CodeWracker/C.A.2017-18-ETECPV/Circuitos/Mesa-1/Lampadas/t73/Com ruido/Desenho/ts-ctrlampp18f4520-2017ver2.pdf

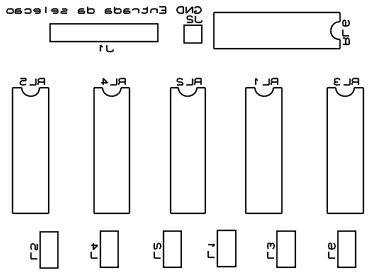
[picture p18: figure]
