CodeWracker/C.A.2017-18-ETECPV/Circuitos/Mesa-1/Lampadas/t73/Sem Ruído/Desenho/ts-ctrlampp18f4520-2017sr-v2.pdf

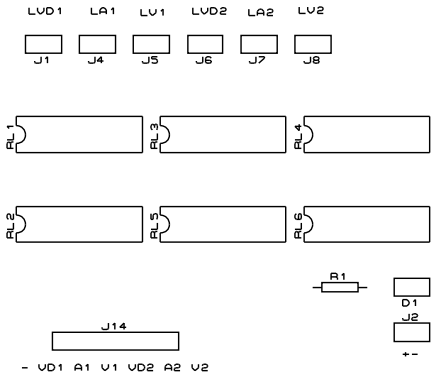
[picture p19: figure]
