CodeWracker/C.A.2017-18-ETECPV/Circuitos/Mesa-1/contadores/Contador de 0 até 60/4518/Sem Ruído/Desenho/ts-ct0a60cmsp18f4520-v1.pdf

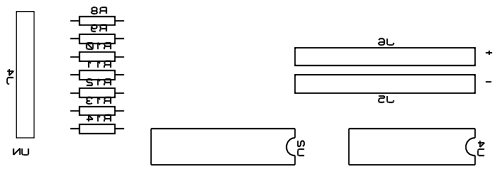
[picture p20: figure]
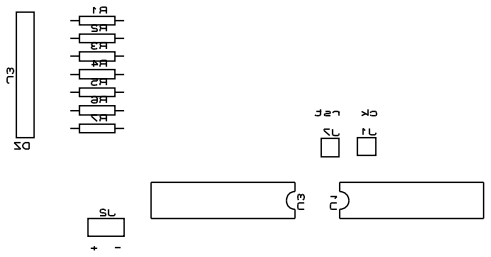
[picture p21: figure]
