CodeWracker/C.A.2017-18-ETECPV/Circuitos/Mesa-1/contadores/Contador de Pontos/4518/com ruido/Desenho/ts-ctptjxp18f4520v2.pdf

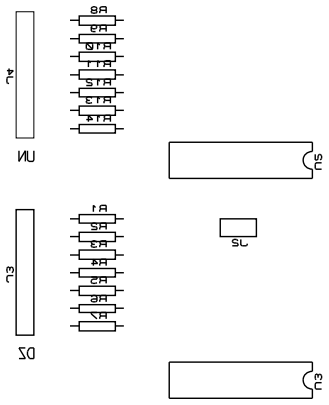
[picture p24: figure]
