CodeWracker/C.A.2017-18-ETECPV/Circuitos/Mesa-1/Lampadas/t73/Com ruido/Desenho/Jumps.png

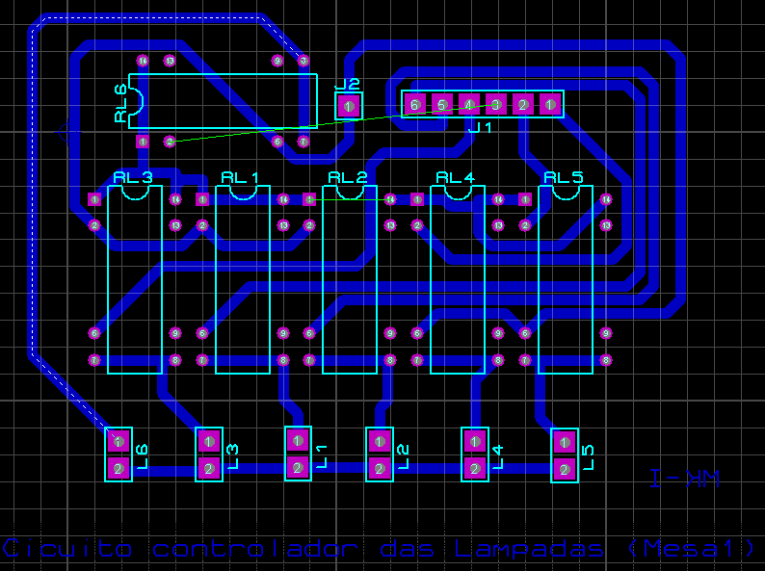
Circuitos/Mesa-1/Lampadas/t73/Com ruido/Desenho/Jumps.png
