CodeWracker/C.A.2017-18-ETECPV/Circuitos/Mesa-1/contadores/Contador de 0 até 60/4518/Sem Ruído/GerbCT0A60CMS - CADCAM Bottom Solder Resist.TXT

G04 PROTEUS RS274X GERBER FILE*
%FSLAX24Y24*%
%MOIN*%
%ADD18C,0.1000*%
%ADD19R,0.1000X0.1000*%
%ADD16C,0.0900*%
%ADD70C,0.1100*%
%ADD17C,0.0080*%
G54D18*
X+30250Y-17000D03*
X+41750Y-16500D03*
X+30875Y-20875D03*
X+35750Y-16500D03*
X+36750Y-16500D03*
X+31750Y-21750D03*
X+24500Y-17000D03*
X+39250Y-31250D03*
X+34750Y-25500D03*
X+37750Y-16500D03*
X+25500Y-21500D03*
X+31750Y-13000D03*
X+24500Y-18000D03*
X+24750Y-12000D03*
X+30250Y-18000D03*
X+29250Y-21000D03*
X+40250Y-31250D03*
G54D19*
X+44500Y-3750D03*
X+44500Y-4750D03*
X+44500Y-5750D03*
X+44500Y-6750D03*
X+44500Y-7750D03*
X+44500Y-8750D03*
X+44500Y-9750D03*
X+44500Y-10750D03*
G54D16*
X+39000Y-7750D03*
X+43000Y-7750D03*
X+39000Y-6750D03*
X+43000Y-6750D03*
X+39000Y-5750D03*
X+43000Y-5750D03*
X+39000Y-4750D03*
X+43000Y-4750D03*
X+39000Y-3750D03*
X+43000Y-3750D03*
X+39000Y-8750D03*
X+43000Y-8750D03*
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
