CodeWracker/C.A.2017-18-ETECPV/Circuitos/Mesa-1/Botoes/desenho/bc-btsv1.pdf

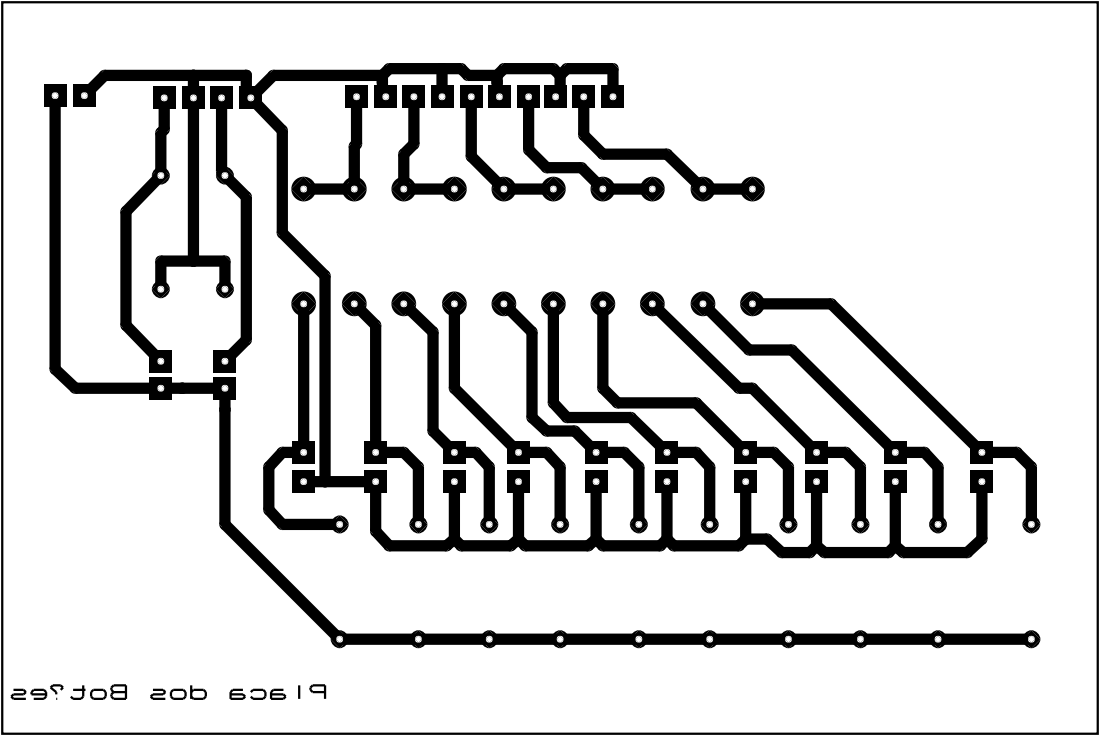
[picture p30: page 1]
