CodeWracker/C.A.2017-18-ETECPV/Circuitos/Mesa-1/Botoes/desenho/ts-btsv1.pdf

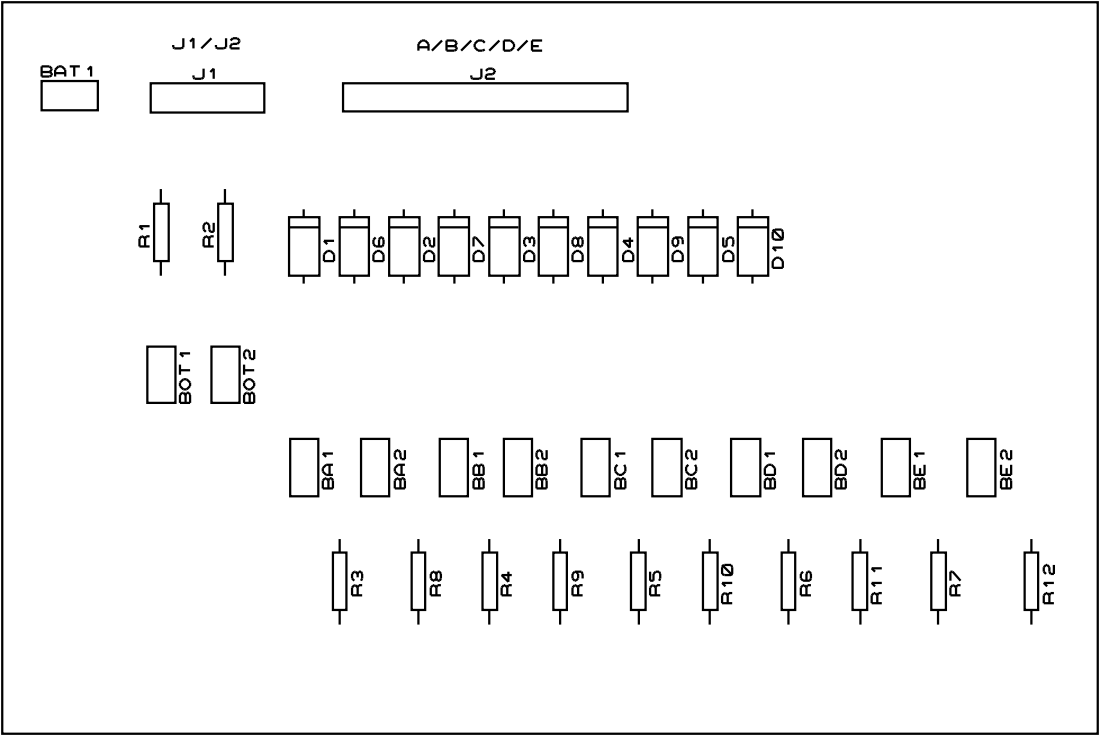
[picture p31: page 1]
