CodeWracker/C.A.2017-18-ETECPV/Circuitos/Mesa-1/Fonte/Desenho/bc-fontedc-6s5v1s9v1a.pdf

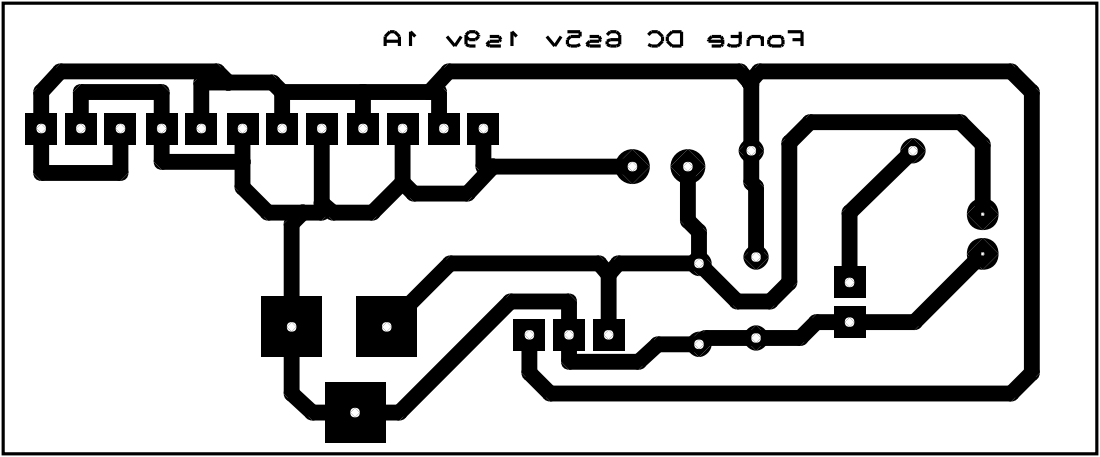
[picture p33: page 1]
