CodeWracker/C.A.2017-18-ETECPV/Circuitos/Mesa-1/Lampadas/t73/Com ruido/Desenho/BC-CtrLampP18F4520-2017ver1.pdf

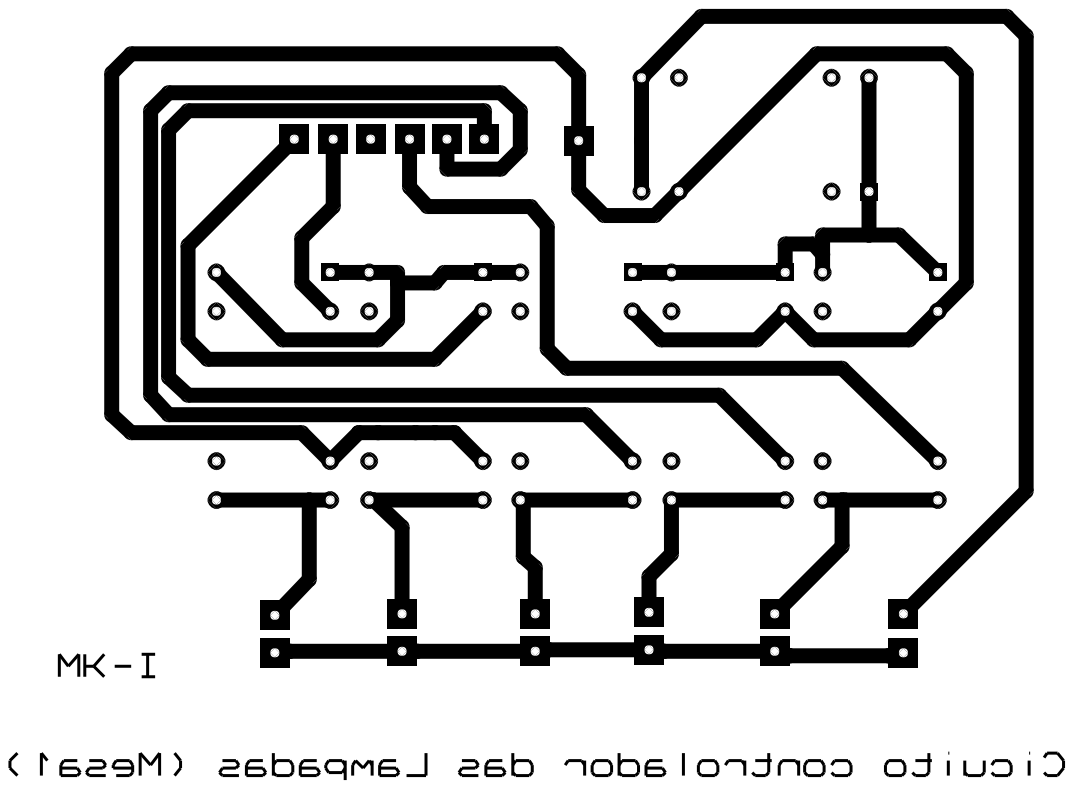
[picture p36: page 1]
