CodeWracker/C.A.2017-18-ETECPV/Circuitos/Mesa-1/Lampadas/t73/Com ruido/Desenho/bc-ctrlampp18f4520-2017ver3.pdf

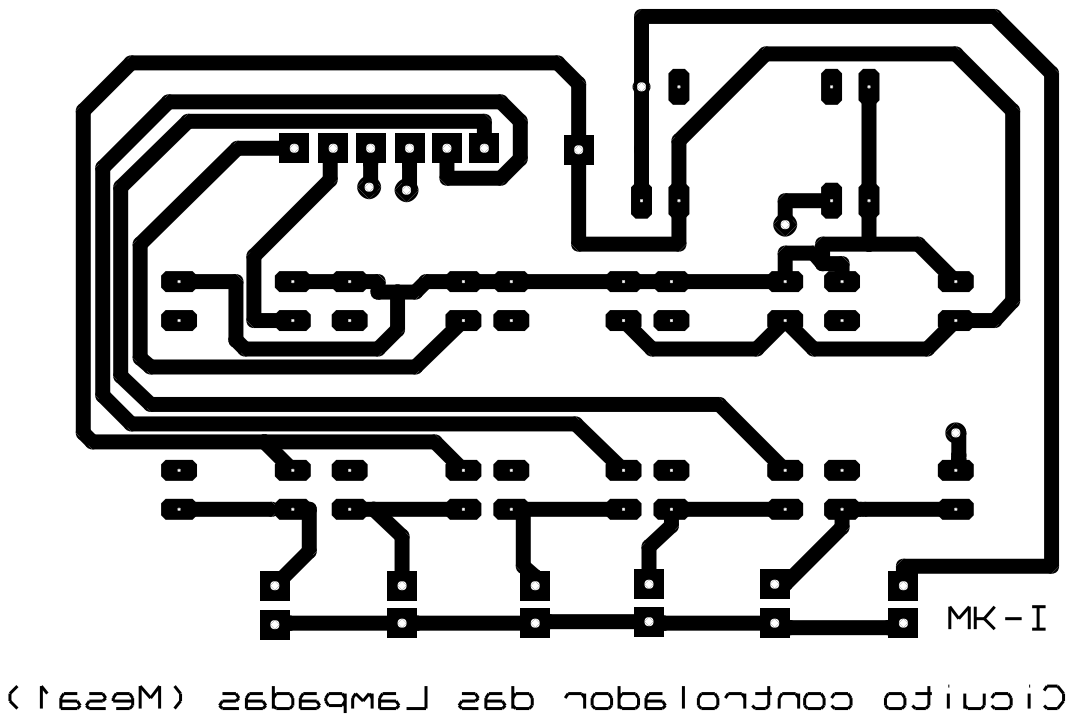
[picture p38: page 1]
