CodeWracker/C.A.2017-18-ETECPV/Circuitos/Mesa-1/Lampadas/t73/Sem Ruído/Desenho/bc-ctrlampp18f4520-2017sr-v2.pdf

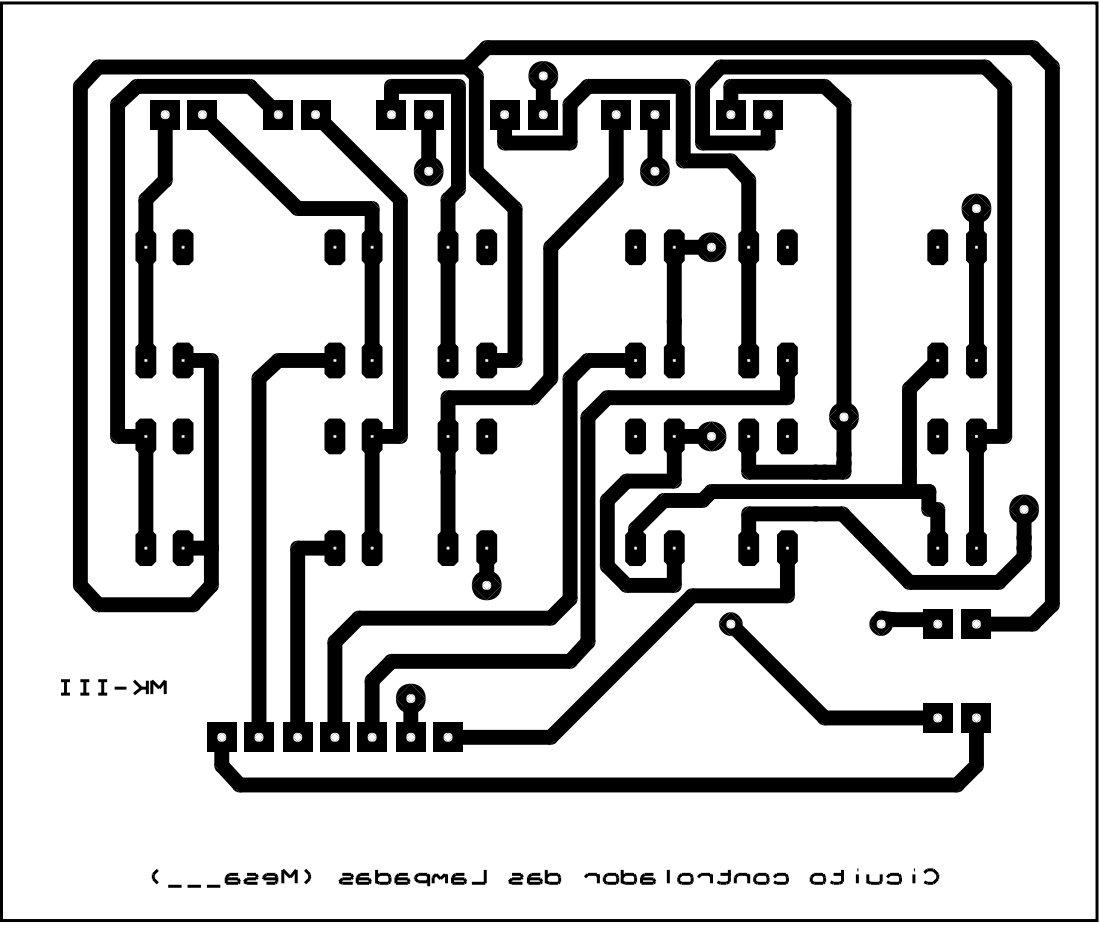
[picture p39: page 1]
