CodeWracker/C.A.2017-18-ETECPV/Circuitos/Mesa-1/contadores/Contador de 0 até 60/4518/Sem Ruído/Desenho/bc-ct0a60cmsp18f4520sr.pdf

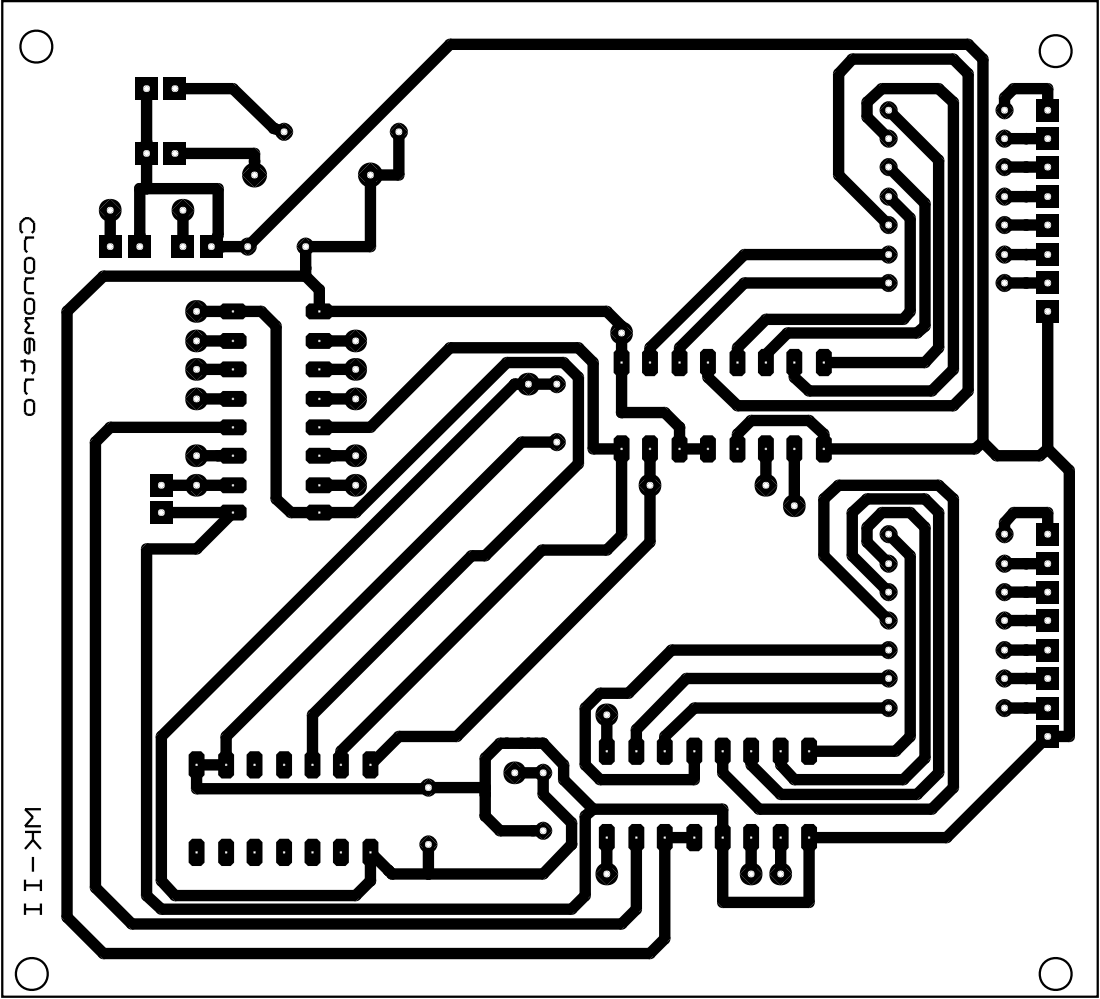
[picture p44: page 1]
