CodeWracker/C.A.2017-18-ETECPV/Circuitos/Mesa-1/contadores/Contador de 0 até 60/4518/Sem Ruído/Desenho/ts-ct0a60cmsp18f4520sr-v3.pdf

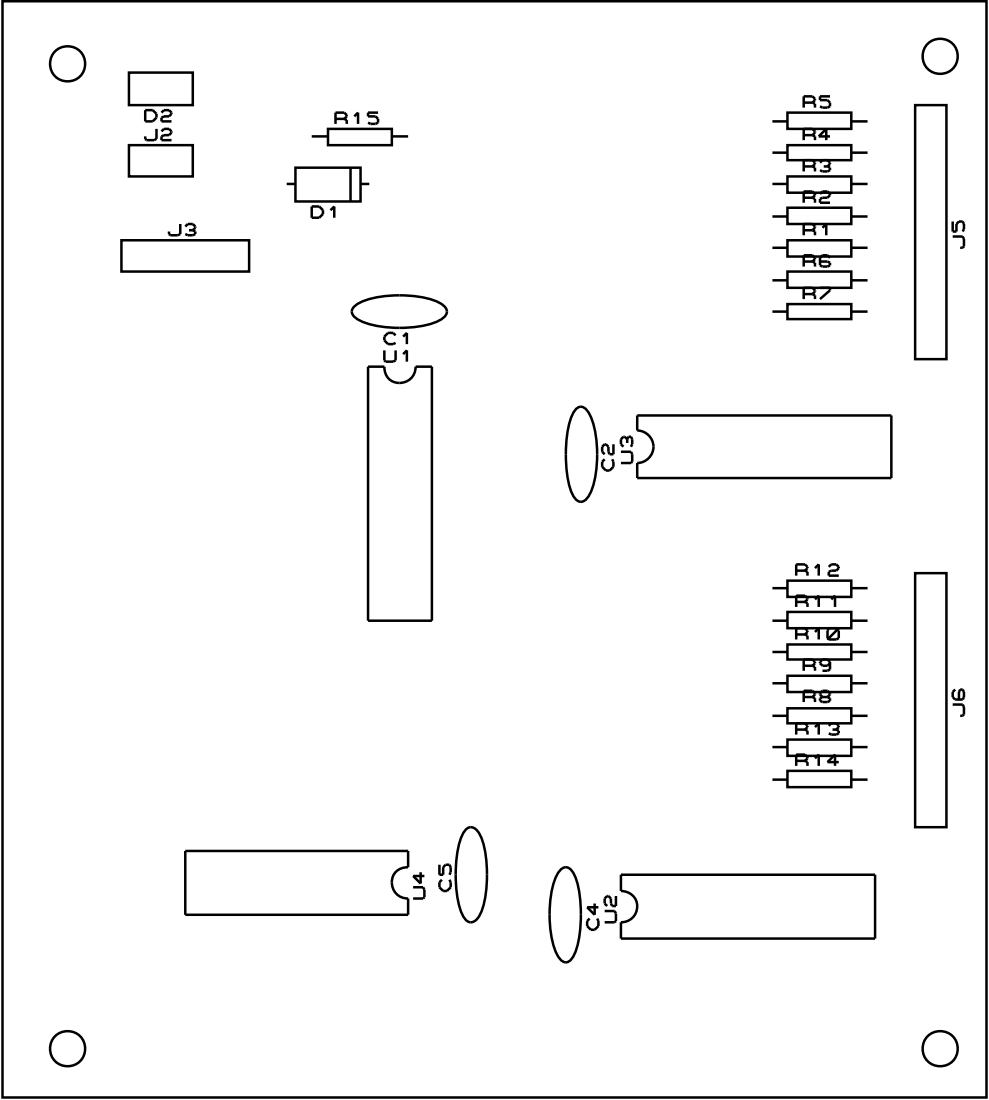
[picture p48: page 1]
