CodeWracker/C.A.2017-18-ETECPV/Circuitos/Mesa-1/contadores/Contador de Pontos/4518/Sem ruido/Desenho/bc-ctptjxp18f4520rs-v2.pdf

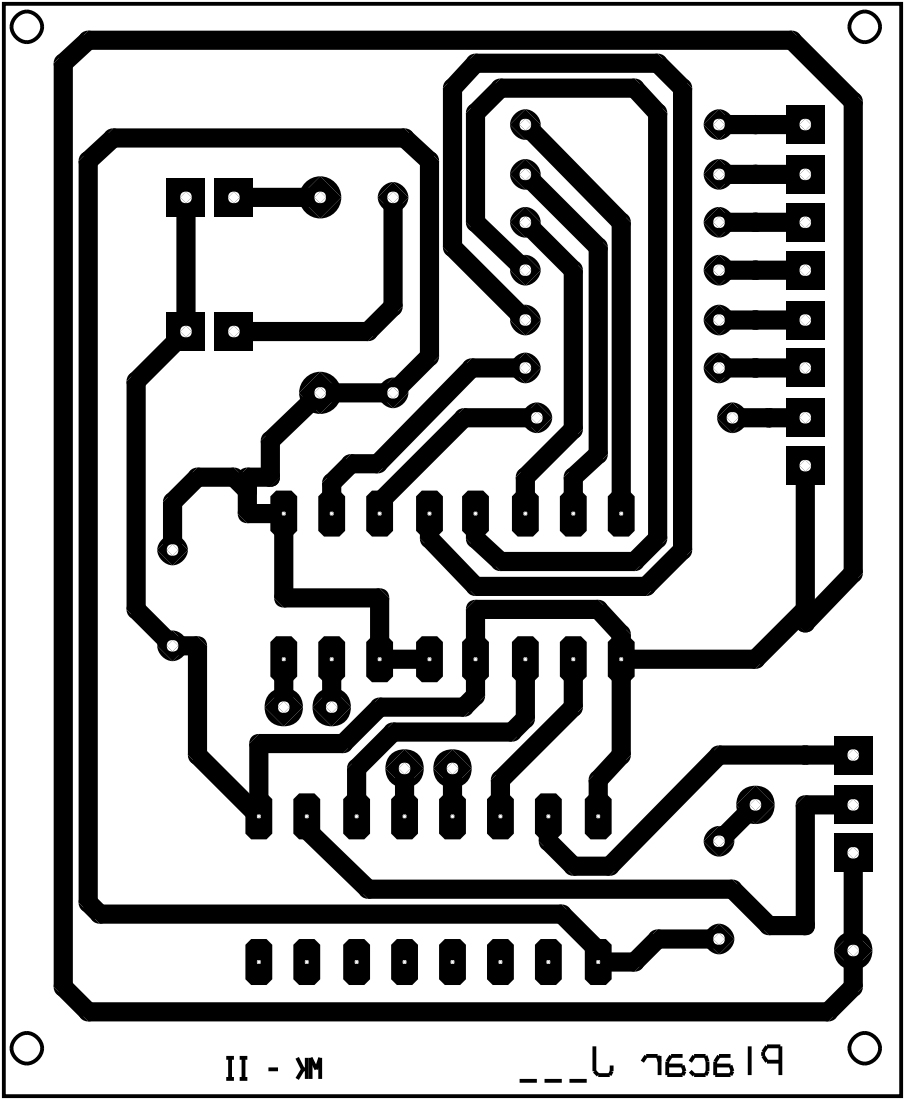
[picture p55: page 1]
