CodeWracker/C.A.2017-18-ETECPV/Circuitos/Mesa-1/contadores/Contador de Pontos/4518/Sem ruido/Desenho/bc-ctptjxp18f4520rs.pdf

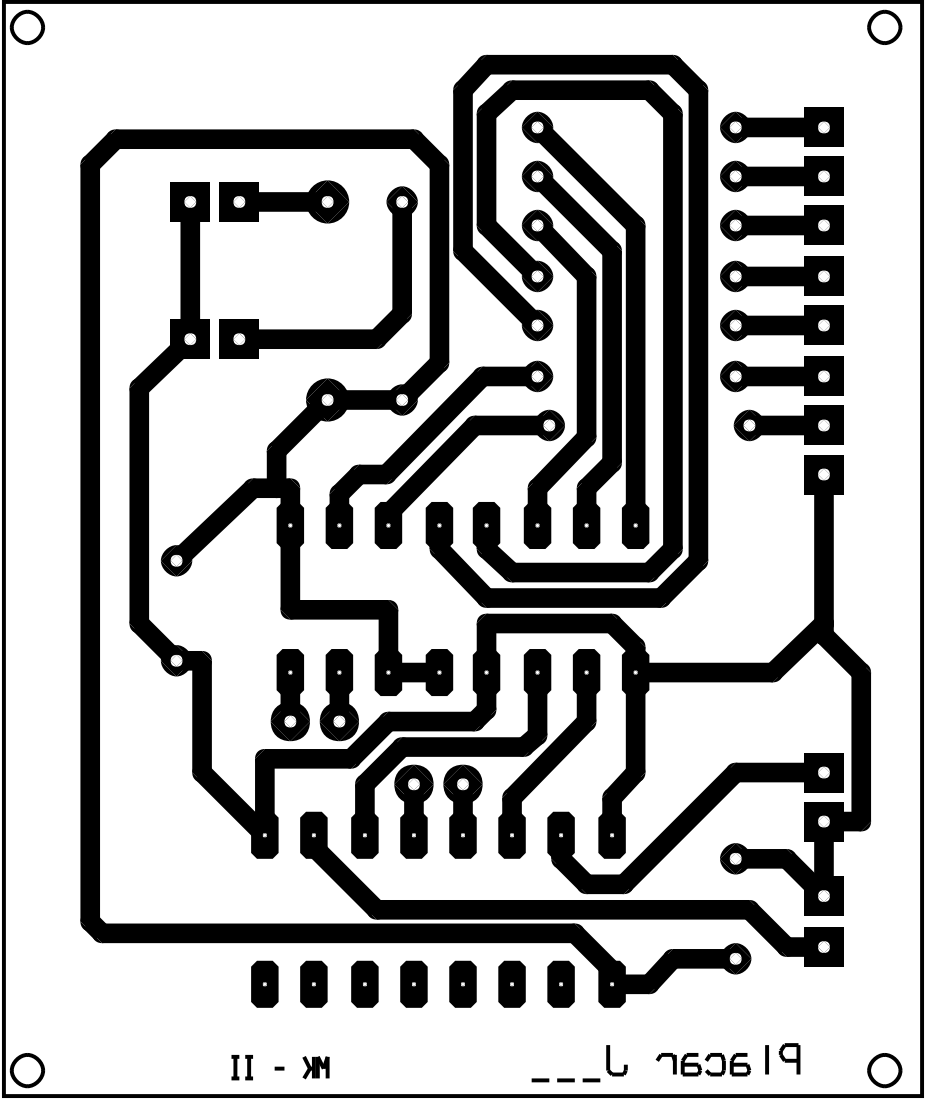
[picture p56: page 1]
