CodeWracker/C.A.2017-18-ETECPV/(list of files, drawings)

Other design files:
Circuitos/Mesa-1/Botoes/Botao.DSN
Circuitos/Mesa-1/Botoes/Botao.LYT
Circuitos/Mesa-1/contadores/Contador de 0 até 60/4518/Sem Ruído/CT0A60CMS.DSN
Circuitos/Mesa-1/contadores/Contador de 0 até 60/4518/Sem Ruído/CT0A60CMS.LYT
Circuitos/Mesa-1/contadores/Contador de Pontos/4518/com ruido/CT-PT.DSN
Circuitos/Mesa-1/contadores/Contador de Pontos/4518/com ruido/CT-PT.LYT
Circuitos/Mesa-1/contadores/Contador de Pontos/4518/Sem ruido/CT-PT.DSN
Circuitos/Mesa-1/contadores/Contador de Pontos/4518/Sem ruido/CT-PT.LYT
Circuitos/Mesa-1/Fonte/FONTE.DSN
Circuitos/Mesa-1/Fonte/FONTE.LYT
Circuitos/Mesa-1/Lampadas/t73/Com ruido/Lp 18f4520.DSN
Circuitos/Mesa-1/Lampadas/t73/Com ruido/Lp 18f4520.LYT
Circuitos/Mesa-1/Lampadas/t73/Sem Ruído/Lp 18f4520.DSN
Circuitos/Mesa-1/Lampadas/t73/Sem Ruído/Lp 18f4520.LYT
Circuitos/Mesa-1/Seletor/Seletor 2.pdsprj
Circuitos/Mesa-1/Seletor/sELETOR.pdsprj
Programa Final/teste ISIS/Projeto do controlador do Quizz P18F4520.DSN
